santiagoperezavila88/MaqTer-GranjaDeGrillos/Demo/Granja_grillos_cfd_lineas_flujo_convecc_natural.png

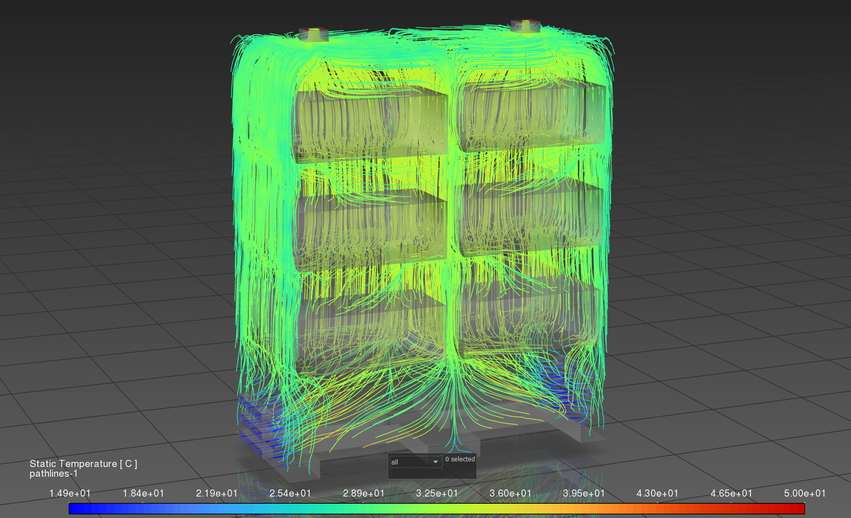
Demo/Granja_grillos_cfd_lineas_flujo_convecc_natural.png
