santiagoperezavila88/MaqTer-GranjaDeGrillos/Demo/Granja_grillos_cfd_temperatura_paredes_rack.png

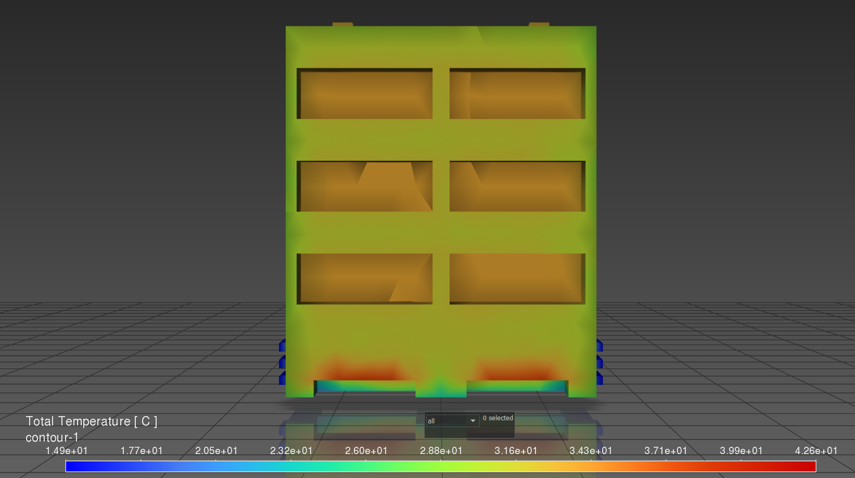
Demo/Granja_grillos_cfd_temperatura_paredes_rack.png
