santiagoperezavila88/MaqTer-GranjaDeGrillos/Demo/Granja_grillos_cad_rack_explosionado.png

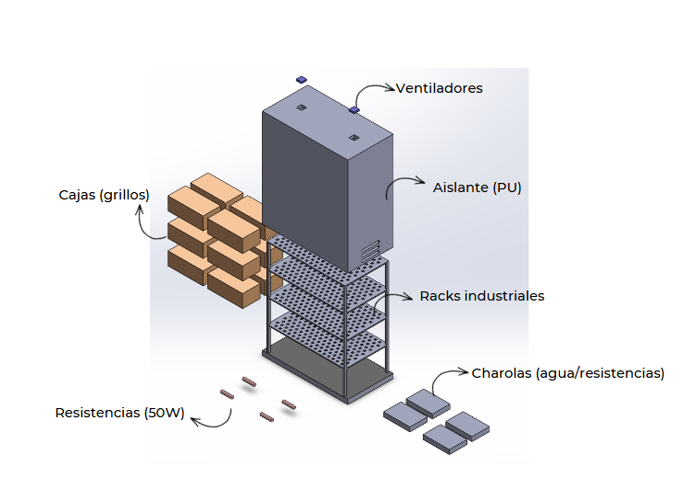
Demo/Granja_grillos_cad_rack_explosionado.png
