santiagoperezavila88/MaqTer-GranjaDeGrillos/Docs/Costos - Granja de grillos.xlsx

Concepto | Especificaciones | Cant. | Precio Unit. | Uds. Total | Subtotal
1. Estantería de Alambre Cromado
Rack Cromado | 72" x 36" x 86" | Cap. 650 lbs/repisa | 1 | $1543.54 | 20 racks | $30870.80
Nota: Descuento aplica por compra ≥ 3 uds
2. Cajas de Almacenamiento
Cajas de almacenamiento | 80 x 40 x 30 cm | 1/rack | $25.00 | 240 cajas | $6000.00
3. Charolas Calefactoras (Cartridge Heater)
Charola Calefactora | 60 x 40 x 10 cm | 50 W c/u | 4/rack | $316.43 | 80 uds | $25314.40
Cartridge Heater 60W - 3"lg - 120 VAC - 36 W/sq in - 1/4# Dia | 200 W/rack → 4,000 W totales (4.0 kW)
4. Ventiladores
AC Infinity Multifan S2 | 120 mm USB - Control de velocidad | 2/rack | $539.00 | 40 uds | $21560.00
5. Control de temperaturas
W1209 Control de Temperatura Digital Sensor Ntc | 2 Pzas por unidad, con una fuente de voltaje de 12 V | 1/rack | $98.00 | 10 uds | $980.00
6. Control de Humedad
Sensor de humedad de Suelo YL-69 | Módulo Yl-38 Para ardunio con amplia compatibilidad | 1/rack | $51.70 | 20 uds | $1034.00
7. Costo de paneles
Canadian Solar TOPBiHiKu6 Bifacial | Módulo Solar 710 W, Bifacial, 48.6 Vcc, Monocristalino. Celda tipo N, Doble Vidrio | 1 | $4281.00 | 2 uds | $8562.00
8. Baterias
Solar Lithium LiFePO4 | Baterry 51.2V/100 Ah, con vida útil de hasta 10 años o 6000 ciclos | 1 | $21177.47 | 2 uds | $42354.94
9. Inversor
Canadian Solar CSI-5KTL1P-GI-FL INVERTER | Potencia nominal 5KW, Eficiencia aprox 98%, Protección contra sobrecorriente, cortocircuito y porlaridad inversa | 1 | $19629.21 | 1 uds | $19629.21
10. Cable
Cable | Metro de cable solar DC 4MM negro | 1 | $20.77 | 12 uds | $249.24
Cable | Cable Calibre 10 AWG (2 fases y tierra) | 1 | $30.00 | 75 uds | $2250.00
Cable | Cable calibre 3/0 AWG | 1 | $350.00 | 4 uds | $1400.00
Barra Neutro/tierra | Barra neutro/tierra 12 conexiones calibres 350 KCM | 1 | $1600.00 | 2 uds | $3200.00
11. Estructura
Block de distribución | Block de distribucción Pdb-55-500-1 Ilsco | 1 | $6290.00 | 2 uds | $12580.00
Block de distribución | Block de distribucción Lda-26-350 Ilsco | 1 | $2260.00 | 2 uds | $4520.00
12. Otros componentes
Conectores | Par de conectores MC4 macho y hembra | 1 | $26.61 | 10 uds | $266.10
Sistema de monitoreo | Unidad de transferencia de datos | 1 | $4573.88 | 1 uds | $4573.88
Placa de montaje | Placa de montaje ciega 300x300 mm metalica Schneider Electric | 1 | $125.00 | 1 uds | $125.00
Otros materiales | Taquetes de compresión | 1 | $60.00 | 16 uds | $960.00
Otros materiales | Tubo conduit pared delgada 3/4 | 1 | $111.00 | 7 uds | $777.00
Otros materiales | Condulet para tubo conduit de 3/4 | 1 | $60.00 | 10 uds | $600.00
Otros materiales | Coples de compresión condult 3/4 | 1 | $20.00 | 6 uds | $120.00
Otros materiales | Abrazaderas tipo "O" 3/4 | 1 | $8.00 | 20 uds | $160.00
13. Servicio
Intalación | Instalación de sistema fotovoltaico | 1 | $20000 | 1 | $20000
Gran Total (precio pendiente de cotización) |  |  |  |  | $208086.57
NOTAS: Los precios presentados pueden variar dependiendo del tiempo de busqueda de cada uno. Precio de Instalación del sistema Fotovoltáico tomado como referencia de una instalación de mayor exigencia (Precio sujeto a las características del proyecto).
Propuestas 1 - Bodega no aislada con Racks Aislados
Aislante térmico de Poliuretano (PU) | Panel de espuma rígida PU para Aislante térmico | 15.258 / Rack | $300.00 | 20 Racks | $97651.00
Gran Total |  |  |  |  | $305737.57
Propuesta 2 - Bodega aislada con racks aislados
Aislante PU para Racks | Espuma rígida de Poliuretano | 15.258 / Rack | $300 | 20 racks | $97651.00
Aislante Pu para Bodega | Panel aislante de poliuretano | 108.782 / Rack | $300 | Toda la bodega | $34810.24
Gran Total |  |  |  |  | $340547.81
