santiagoperezavila88/MaqTer-GranjaDeGrillos/Demo/Granja_grillos_cad_materiales_envolvente.png

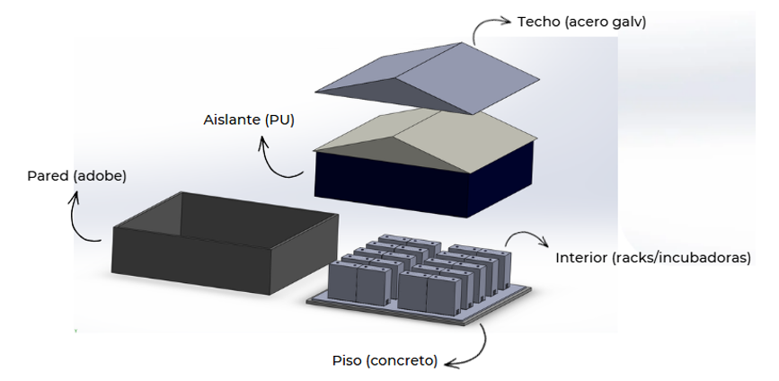
Demo/Granja_grillos_cad_materiales_envolvente.png
