santiagoperezavila88/MaqTer-GranjaDeGrillos/CAD/SLDPRT/Assem_racks/Assem_racks.SLDASM

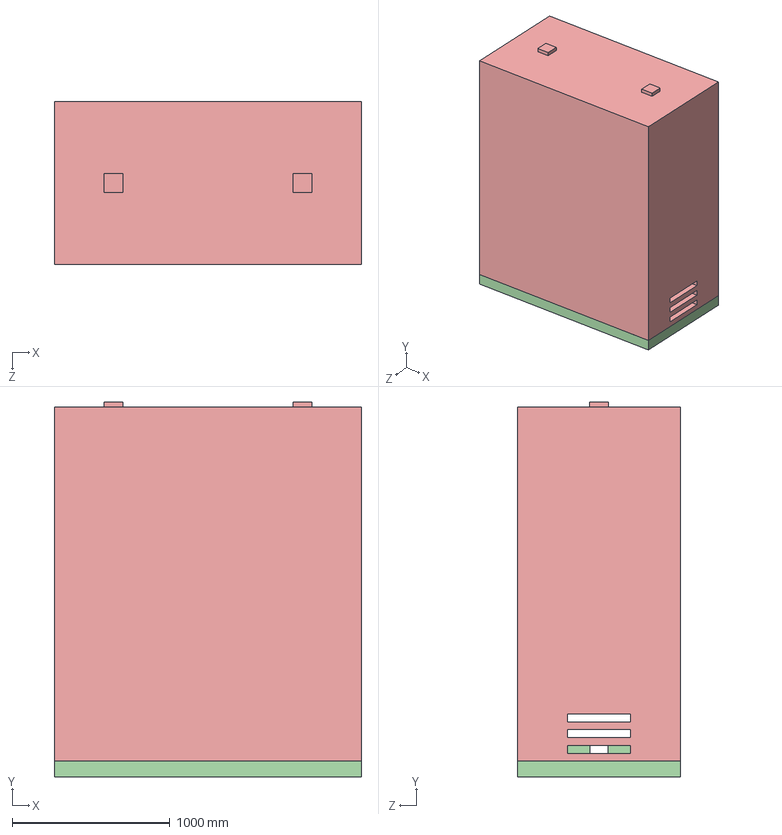
[picture p31: CAD file, 2026-09-29]
CAD/SLDPRT/Assem_racks/Assem_racks.SLDASM
1948.8 x 2377.4 x 1034.4 mm
Racks
Racks_aislante
Racks_cajas
Racks_charolas
Racks_resistencias
