santiagoperezavila88/MaqTer-GranjaDeGrillos/CAD/SLDPRT/Assem_bodega/Assem_Bodega_Rakcs.SLDASM

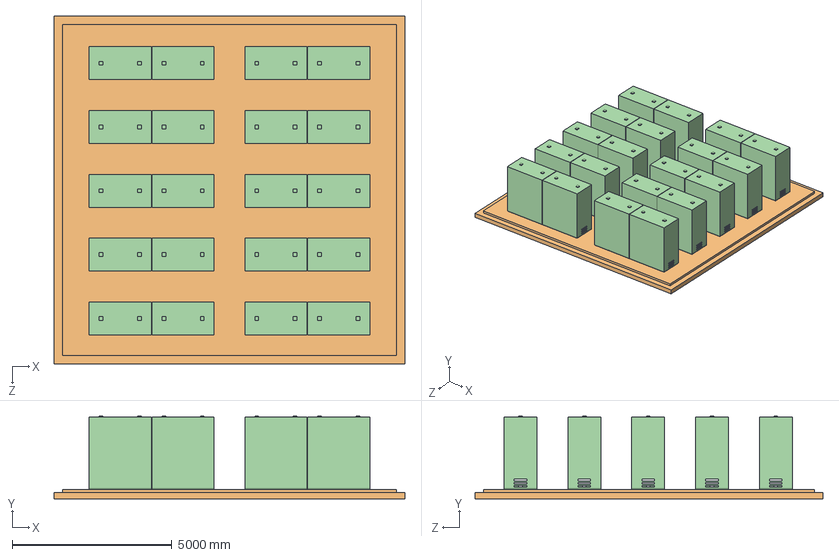
[picture p32: CAD file, 2026-09-29]
CAD/SLDPRT/Assem_bodega/Assem_Bodega_Rakcs.SLDASM
11000.0 x 2597.4 x 10900.0 mm
Racks x 20
bodega + Racks
bodega_pared
bodega_techo
