santiagoperezavila88/MaqTer-GranjaDeGrillos/CAD/SLDPRT/Assem_bodega/bodega_pared.SLDPRT

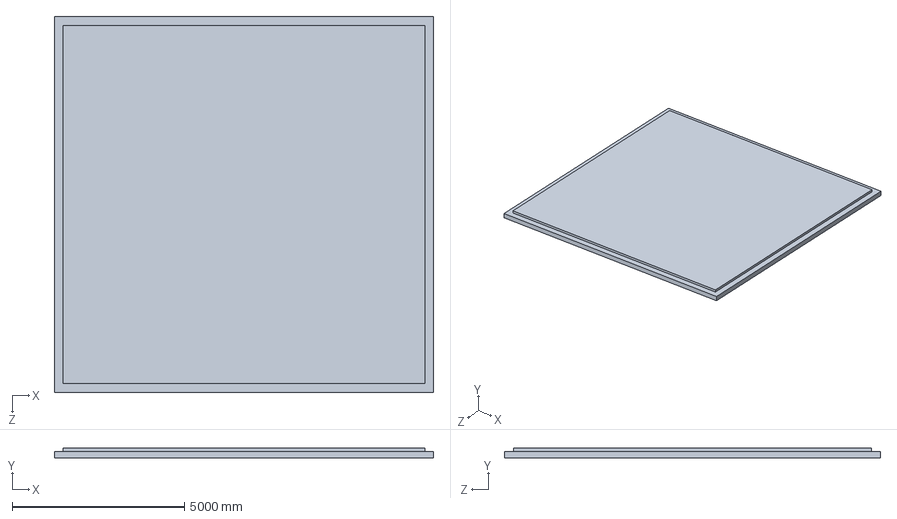
[picture p33: CAD file, 2026-09-29]
CAD/SLDPRT/Assem_bodega/bodega_pared.SLDPRT
11000.0 x 300.0 x 10900.0 mm
