santiagoperezavila88/MaqTer-GranjaDeGrillos/CAD/SLDPRT/Assem_racks/Racks_aislante.SLDPRT

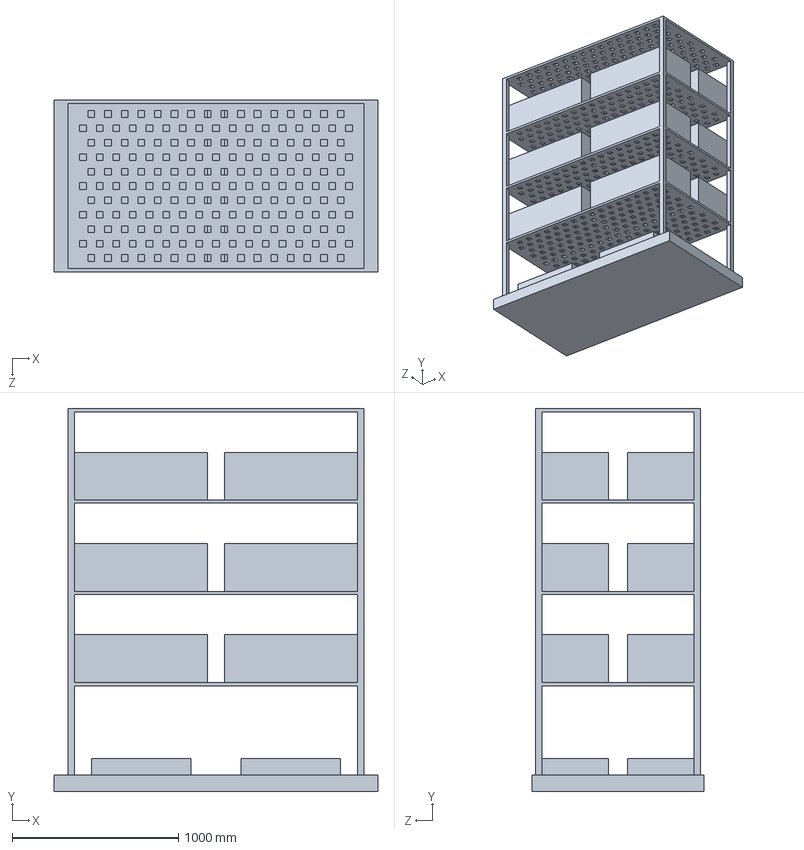
[picture p34: CAD file, 2026-09-29]
CAD/SLDPRT/Assem_racks/Racks_aislante.SLDPRT
1948.8 x 2304.4 x 1034.4 mm
