santiagoperezavila88/MaqTer-GranjaDeGrillos/CAD/SLDPRT/Assem_racks/Racks_resistencias.SLDPRT

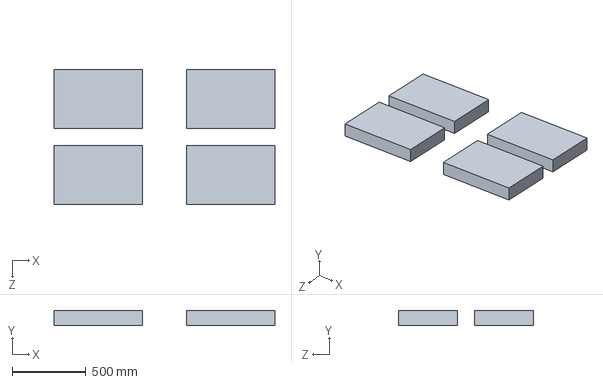
[picture p35: CAD file, 2026-09-29]
CAD/SLDPRT/Assem_racks/Racks_resistencias.SLDPRT
1500.0 x 100.0 x 914.4 mm
