santiagoperezavila88/MaqTer-GranjaDeGrillos/CAD/SLDPRT/Racks.SLDPRT

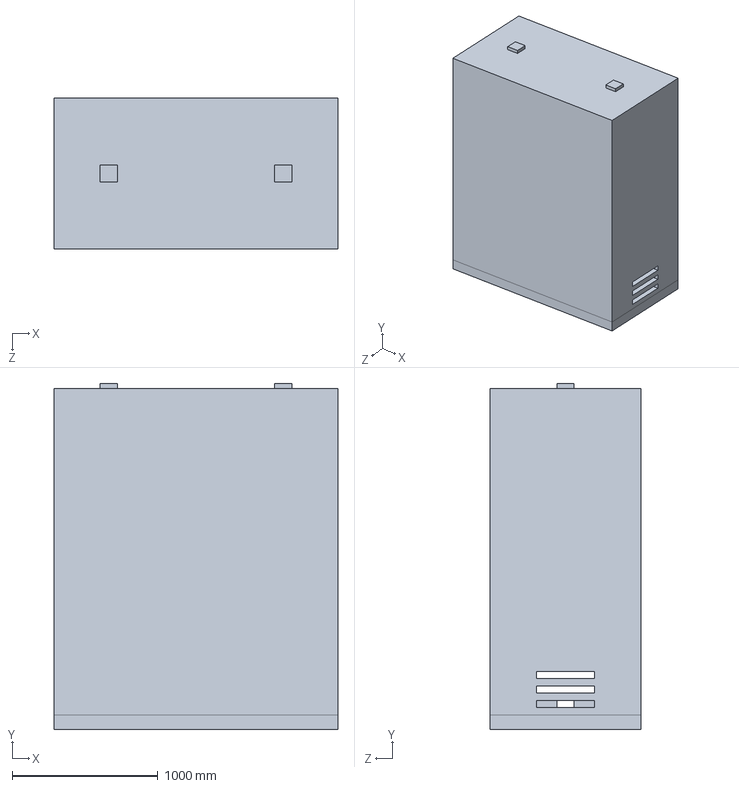
[picture p36: CAD file, 2026-09-29]
CAD/SLDPRT/Racks.SLDPRT
1948.8 x 2377.4 x 1034.4 mm
