santiagoperezavila88/MaqTer-GranjaDeGrillos/CAD/SLDPRT/Assem_racks/Racks_ventiladores.SLDPRT

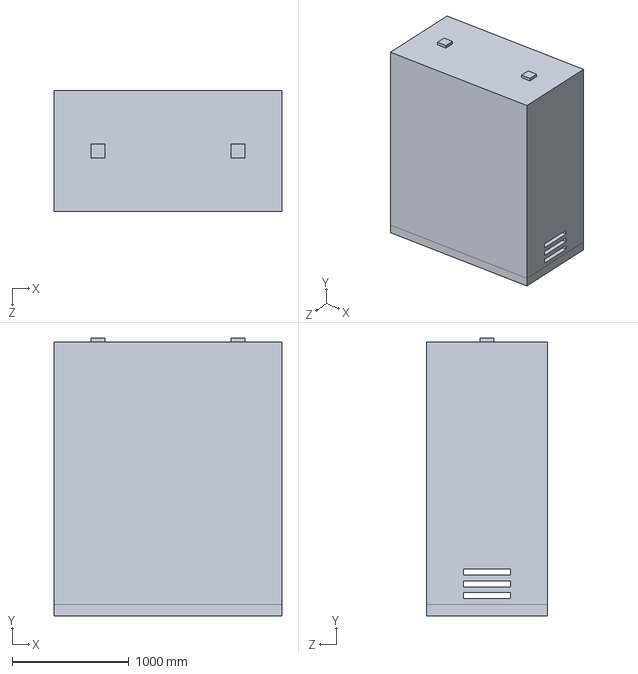
[picture p37: CAD file, 2026-09-29]
CAD/SLDPRT/Assem_racks/Racks_ventiladores.SLDPRT
1948.8 x 2377.4 x 1034.4 mm
