santiagoperezavila88/MaqTer-GranjaDeGrillos/(list of files, cad)

Other CAD files:
CAD/SLDPRT/bodega.SLDPRT
CAD/SLDPRT/Assem_bodega/bodega_techo.SLDPRT
CAD/SLDPRT/Assem_bodega/bodega_aislantes.SLDPRT
CAD/SLDPRT/bodega + Racks.SLDPRT
CAD/SLDPRT/Assem_racks/Racks_cajas.SLDPRT
CAD/SLDPRT/Assem_racks/Racks_charolas.SLDPRT
CAD/Parasolid.x_t/Bodega Grillos1.x_t
CAD/Parasolid.x_t/Racks_2 ventiladores.x_t
